dashjay/PCB_amplifier/(list of files, drawings)

Other design files:
PCB1.PcbDoc
PCB2.PcbDoc
PCB_Project/PCB_Project.PrjPcb
Sheet2.SchDoc
库文件2018/teach2018.PcbLib
库文件2018/teach2018.SCHLIB
