dashjay/PCB_amplifier/(commit log)

2019-05-12 交作业，电子技术实习OC
    [PCB1.PcbDoc, PCB2.PcbDoc, PCB_Project.PrjPcb, Sheet2.SchDoc, teach2018.PcbLib, teach2018.SCHLIB]
2019-06-18 添加浪费时间的报告
